ritter30/senior-design/README.md

# G.A.I.N.S Team 19
Cameron Williams \
Max Ritter \
Mark Melvin \
Aidan Leib

## Documentation

All documentation for the project is located in [`./docs`](./docs/).

Hyperlinks to frequently used:

- [Git Commands Cheat Sheet](./docs/git_cheatsheet.md)
- etc...
