ritter30/senior-design/docs/git_cheatsheet.md

## Git Pull
> [!IMPORTANT]
> Make sure to run this command _every_ time to open the project.

```bash
git pull
```

## Checkout/Switch Branches
```bash
git checkout <branch>
```

## Merge Main into Branch
```bash
git checkout <branch>
git fetch origin
git merge origin/main
```
