ritter30/senior-design/app/graphics/accuracy.png

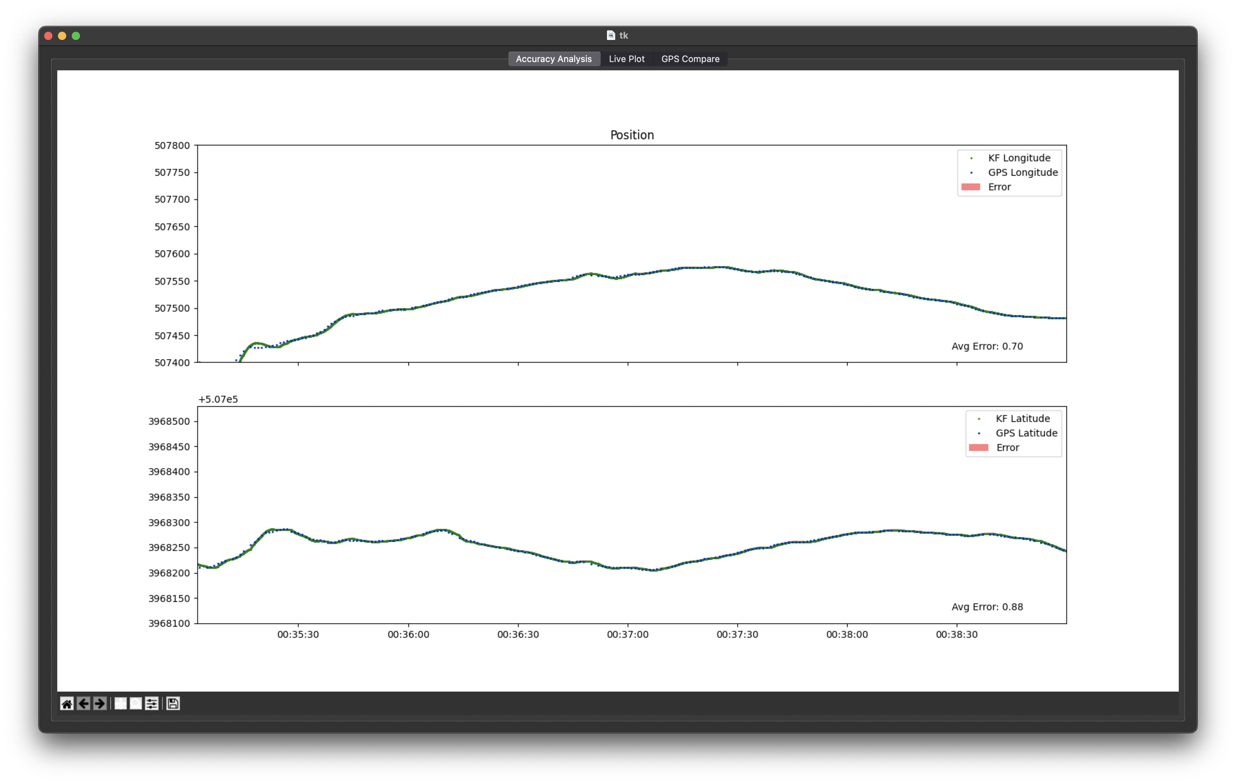
app/graphics/accuracy.png
