ritter30/senior-design/app/graphics/lat_and_lon_with_kf.png

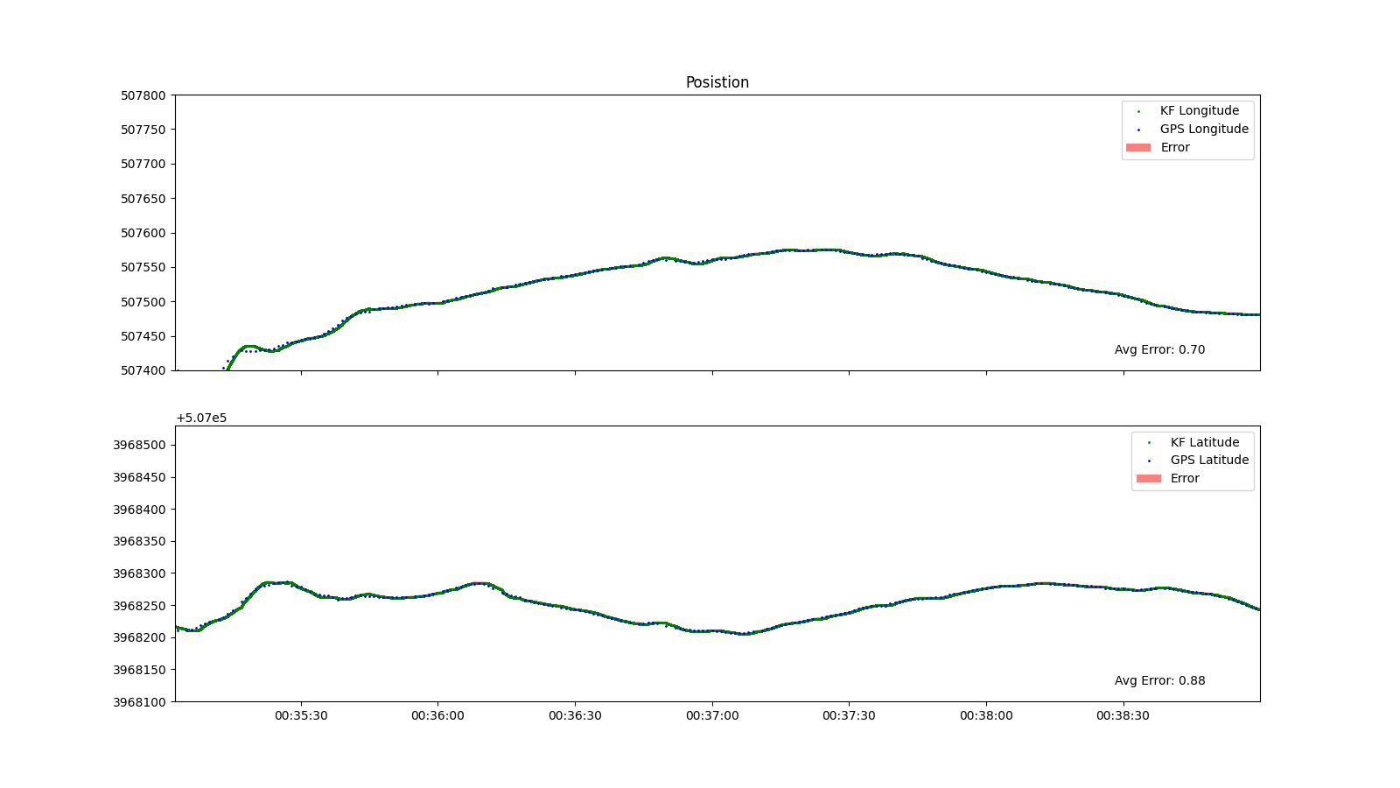
app/graphics/lat_and_lon_with_kf.png
