ritter30/senior-design/app/graphics/my_route_run01.png

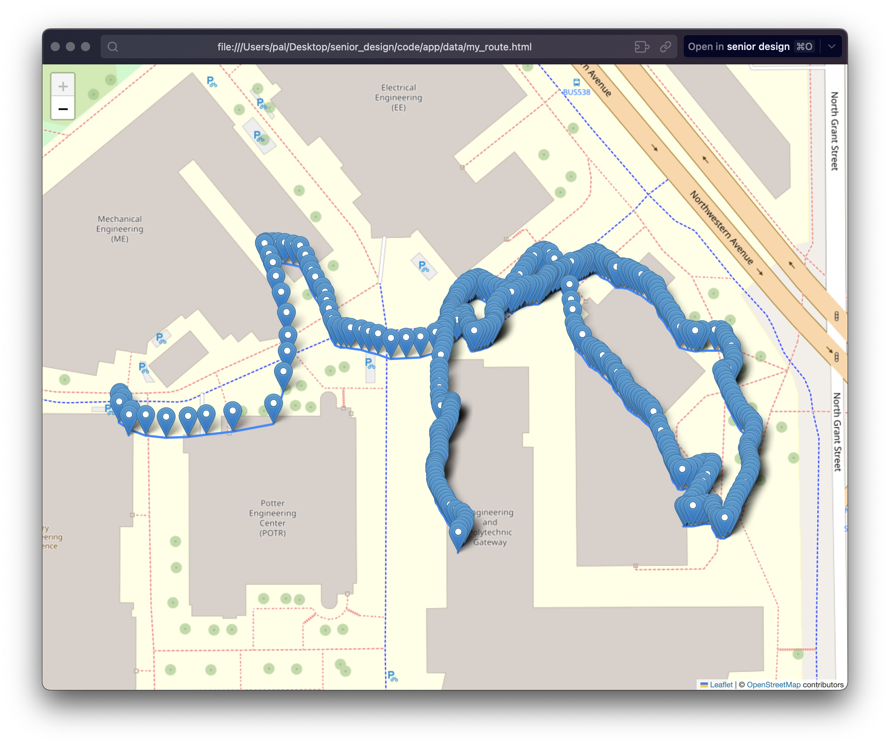
app/graphics/my_route_run01.png
