ritter30/senior-design/app/graphics/orient_demo.png

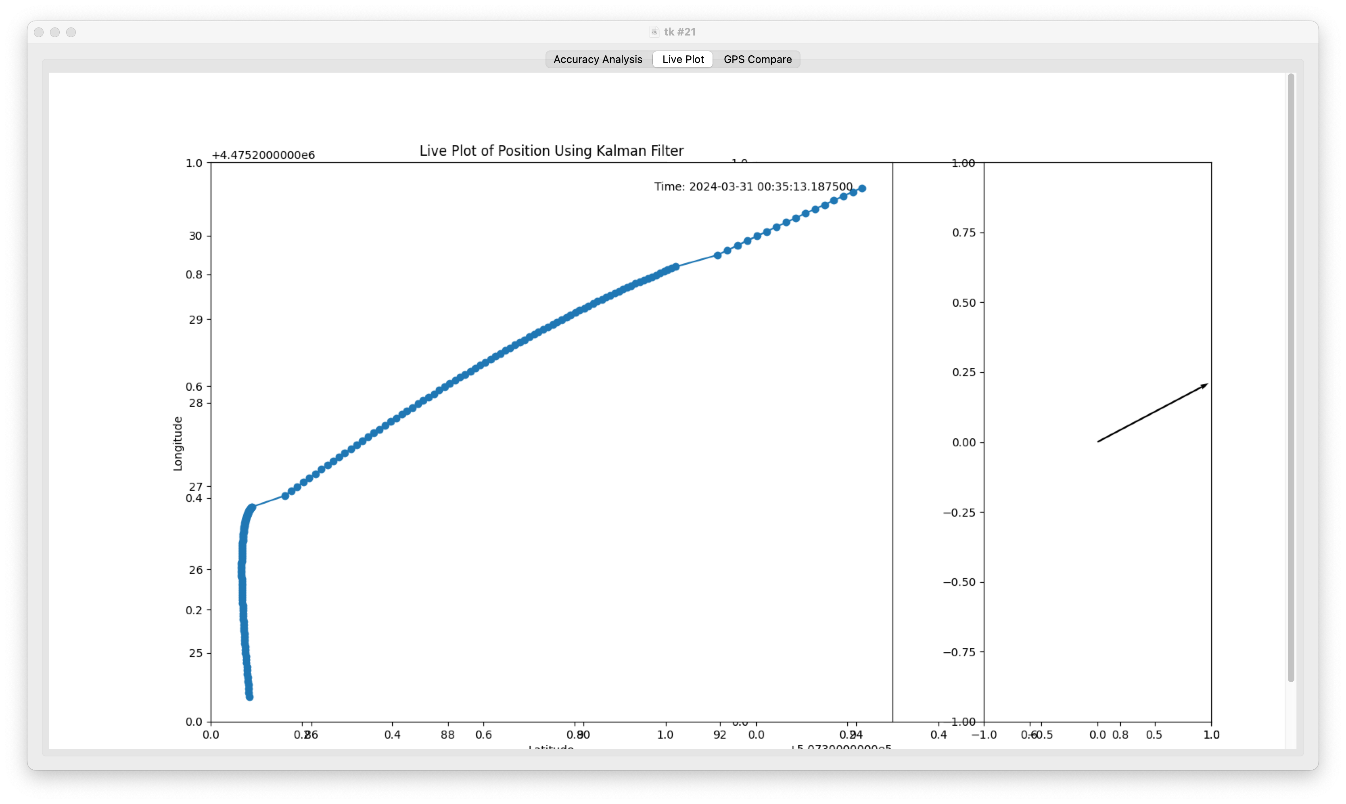
app/graphics/orient_demo.png
