ritter30/senior-design/app/graphics/zoomed_accuracy.png

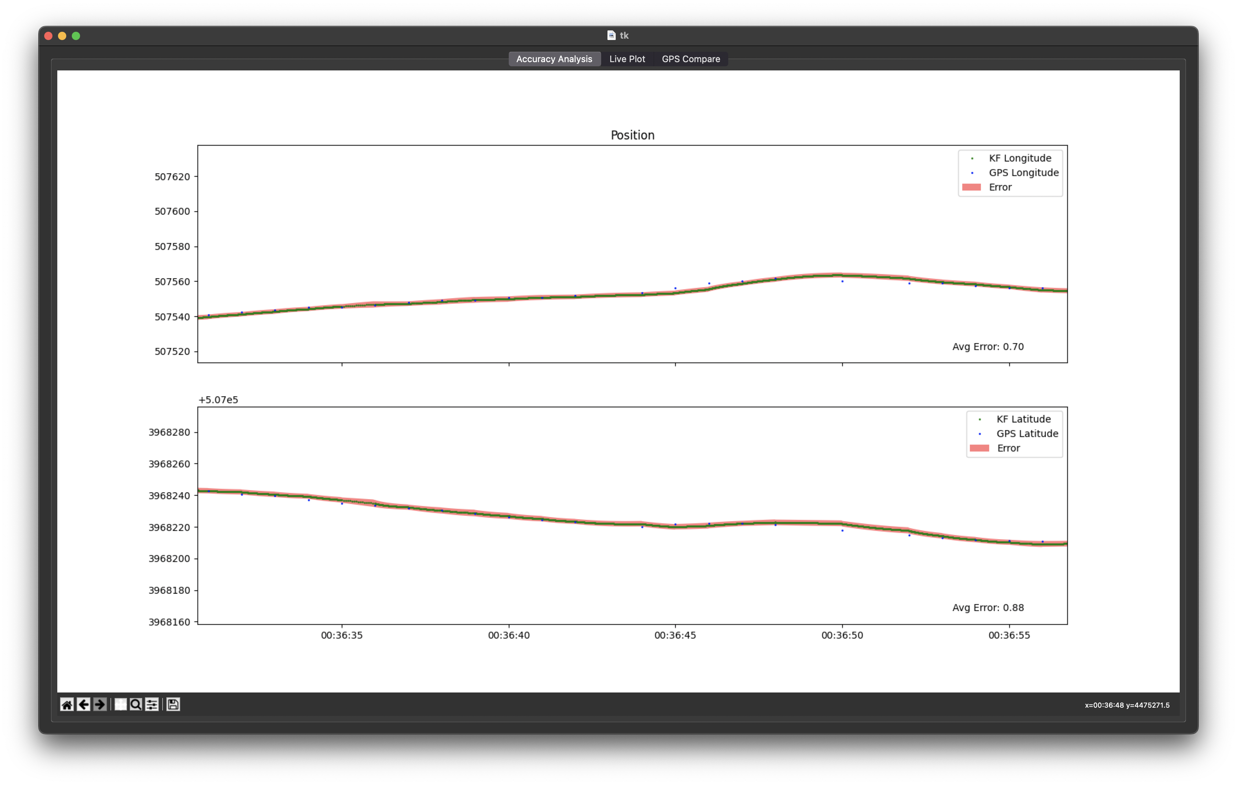
app/graphics/zoomed_accuracy.png
