ritter30/senior-design/Simulations/low_battery_indicator.asc

R1: res; 1k
R2: res; 10k
R3: res; 30k
R4: res; 100k
U1: UniversalOpAmp2
V1: voltage; 5
V2: voltage; SINE(3 1 10)
Named nets: 0, 5V, VIN, VOUT, VHYST
.tran 1
