ritter30/senior-design/Simulations/power_or_diodes.asc

C1: cap; 470µ
D1: diode; A
D2: schottky; 1N5817
R1: res; 10k
V1: voltage; 5V
V2: voltage; PULSE(0 5 0 0.001 0.001 0.05 0.1 100)
Named nets: 0, 5V, VUSB
.model A D(Ron=0.086 Roff=1Meg Vfwd=0.043 Vrev=2)
.tran 1
