ritter30/senior-design/PCBs/GAINS_PCB/GAINS_PCB.kicad_pcb

## KiCad design PCBs/GAINS_PCB/GAINS_PCB.kicad_pcb (2024-04-13)

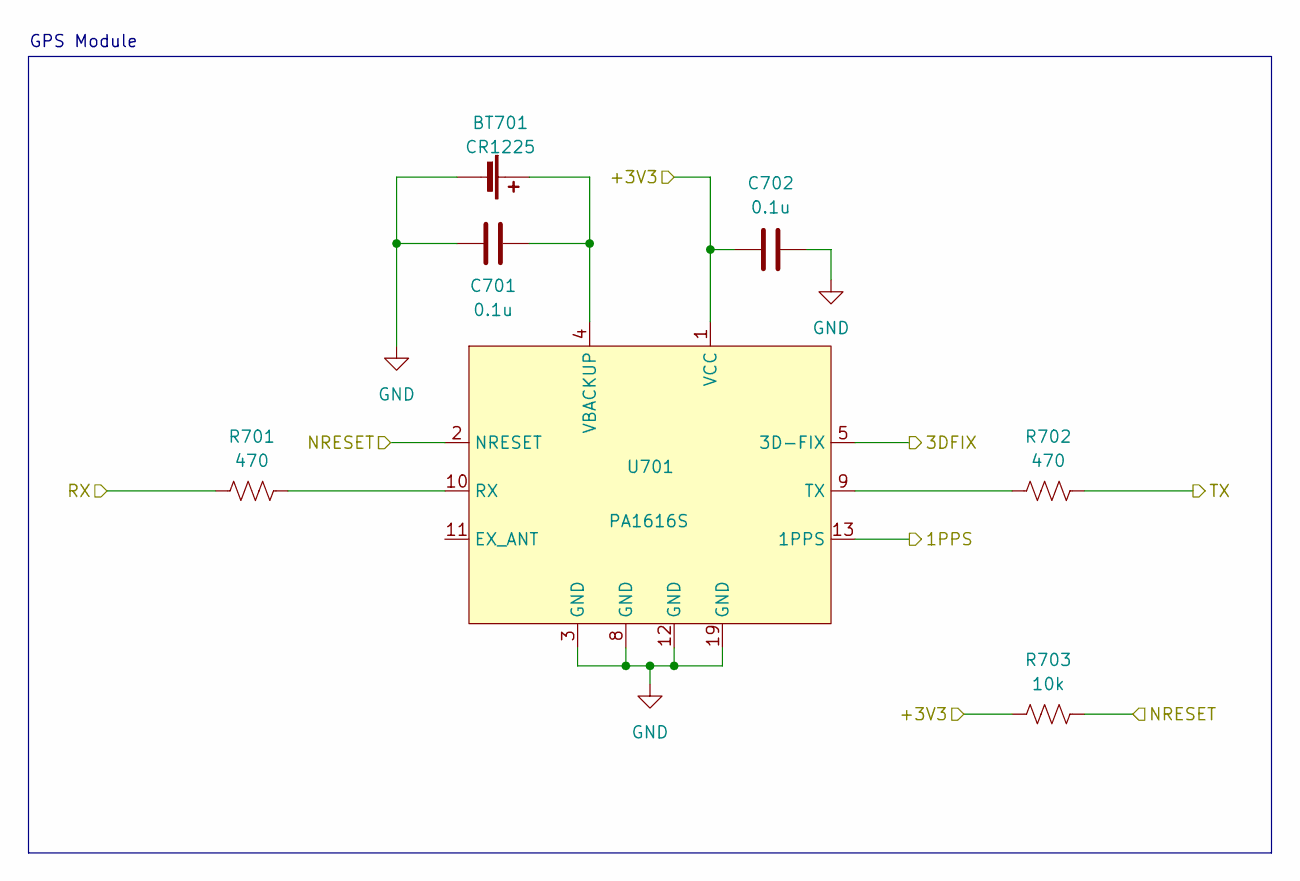
[picture p6: schematic gps.kicad_sch, G.A.I.N.S. GPS Module]

Parts:
BT701: CR1225; Battery_Panasonic_CR1220-VCN_Vertical_CircularHoles
C701, C702: 0.1u; C_0805_2012Metric_Pad1.18x1.45mm_HandSolder
R701, R702: 470; R_0805_2012Metric_Pad1.20x1.40mm_HandSolder
R703: 10k; R_0805_2012Metric_Pad1.20x1.40mm_HandSolder
U701: PA1616S

Connections:
/GPS/1PPS: U701.13 (1PPS); also elsewhere on the board
/GPS/3DFIX: U701.5 (3D-FIX); also elsewhere on the board
/GPS/+3V3: C702.1, R703.1, U701.1 (VCC); also elsewhere on the board
/GPS/NRESET: R703.2, U701.2 (NRESET); also elsewhere on the board
/GPS/RX: R701.1; also elsewhere on the board
/GPS/TX: R702.1; also elsewhere on the board
GND: BT701.2 (-), C701.1, C702.2, U701.3 (GND), U701.8 (GND), U701.12 (GND), U701.19 (GND); also elsewhere on the board
unnamed: BT701.1 (+), C701.2, U701.4 (VBACKUP)
unnamed: R701.2, U701.10 (RX)
unnamed: R702.2, U701.9 (TX)

Notes on the sheet:
GPS Module

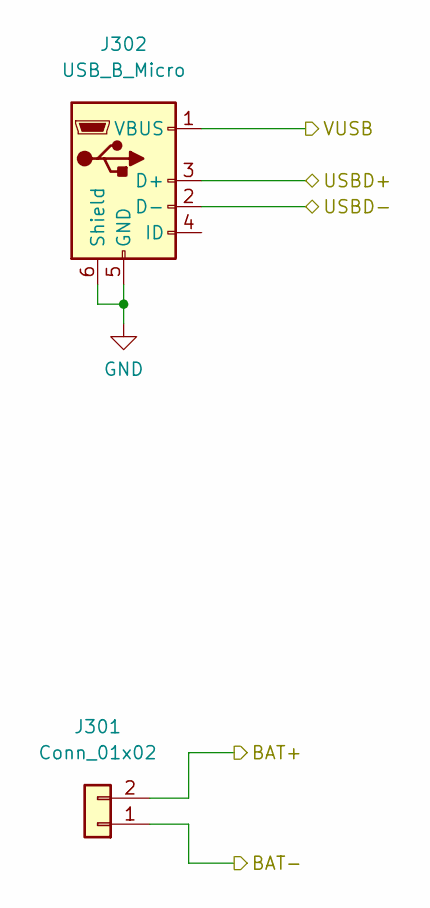
[picture p7: schematic connectors.kicad_sch, G.A.I.N.S. Connectors]

Parts:
J301: Conn_01x02; JST_GH_BM02B-GHS-TBT_1x02-1MP_P1.25mm_Vertical
J302: USB_B_Micro; USB_Micro-B_Amphenol_10104110_Horizontal

Connections:
/Connectors/BAT+: J301.2; also elsewhere on the board
/Connectors/BAT-: J301.1
/Connectors/USBD+: J302.3 (D+); also elsewhere on the board
/Connectors/USBD-: J302.2 (D-); also elsewhere on the board
/Connectors/VUSB: J302.1 (VBUS); also elsewhere on the board
GND: J302.5 (GND), J302.6 (Shield); also elsewhere on the board

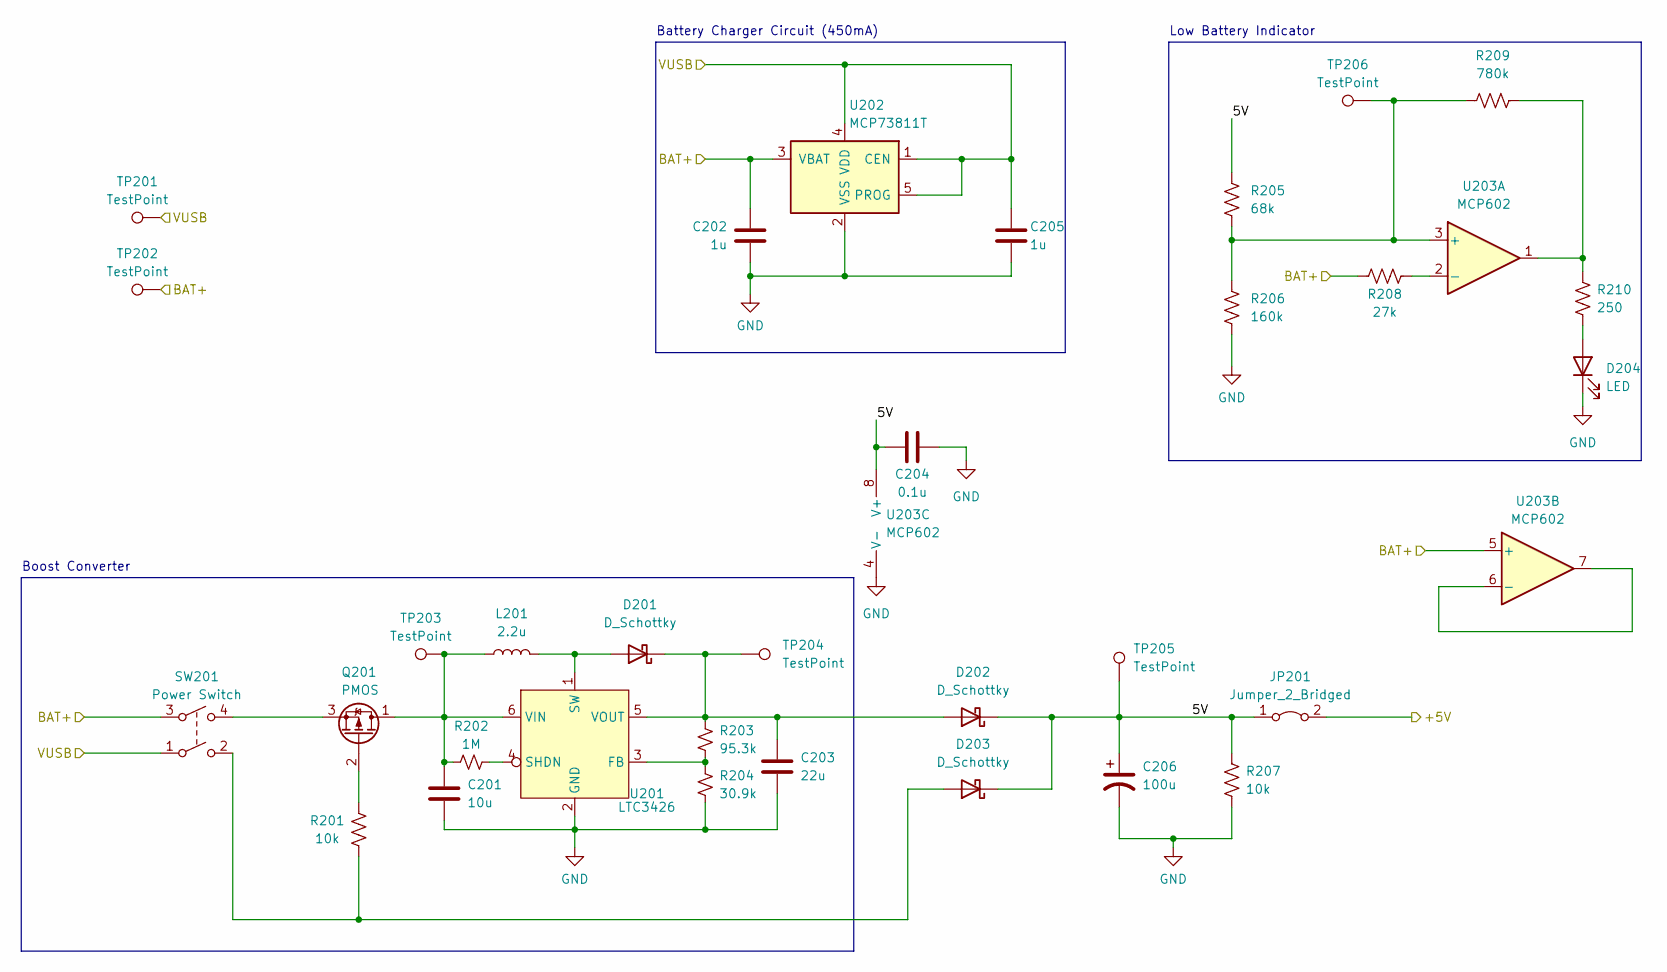
[picture p8: schematic power.kicad_sch, G.A.I.N.S. PSU]

Parts:
C201: 10u; C_0805_2012Metric_Pad1.18x1.45mm_HandSolder
C202, C205: 1u; C_0805_2012Metric_Pad1.18x1.45mm_HandSolder
C203: 22u; CP_Radial_D5.0mm_P2.00mm
C204: 0.1u; C_0805_2012Metric_Pad1.18x1.45mm_HandSolder
C206: 100u; CP_Radial_D10.0mm_P5.00mm
D201, D202, D203: D_Schottky; D_DO-41_SOD81_P10.16mm_Horizontal
D204: LED; LED_D5.0mm
JP201: Jumper_2_Bridged; SolderJumper-2_P1.3mm_Open_Pad1.0x1.5mm
L201: 2.2u; L_Radial_D8.7mm_P5.00mm_Fastron_07HCP
Q201: PMOS; TO-220-3_Vertical
R201, R207: 10k; R_0805_2012Metric_Pad1.20x1.40mm_HandSolder
R202: 1M; R_0805_2012Metric_Pad1.20x1.40mm_HandSolder
R203: 95.3k; R_0805_2012Metric_Pad1.20x1.40mm_HandSolder
R204: 30.9k; R_0805_2012Metric_Pad1.20x1.40mm_HandSolder
R205: 68k; R_0805_2012Metric_Pad1.20x1.40mm_HandSolder
R206: 160k; R_0805_2012Metric_Pad1.20x1.40mm_HandSolder
R208: 27k; R_0805_2012Metric_Pad1.20x1.40mm_HandSolder
R209: 780k; R_0805_2012Metric_Pad1.20x1.40mm_HandSolder
R210: 250; R_0805_2012Metric_Pad1.20x1.40mm_HandSolder
SW201: Power Switch
TP201, TP202, TP203, TP204, TP205, TP206: TestPoint; PinHeader_1x01_P1.27mm_Vertical
U201: LTC3426; TSOT-23-6_HandSoldering
U202: MCP73811T; SOT-23-5_HandSoldering
U203: MCP602; DIP-8_W7.62mm_Socket

Connections:
/Connectors/BAT+: C202.1, R208.1, SW201.3, TP202.1, U202.3 (VBAT), U203.5 (+); also elsewhere on the board
/Connectors/VUSB: C205.1, SW201.1, TP201.1, U202.1 (CEN), U202.4 (VDD), U202.5 (PROG); also elsewhere on the board
/Power/5V: C204.1, C206.1, D202.1 (K), D203.1 (K), JP201.1 (A), R205.2, R207.1, TP205.1, U203.8 (V+)
/Power/+5V: JP201.2 (B); also elsewhere on the board
GND: C201.2, C202.2, C203.2, C204.2, C205.2, C206.2, D204.1 (K), R204.2, R206.1, R207.2, U201.2 (GND), U202.2 (VSS), U203.4 (V-); also elsewhere on the board
unnamed: D201.2 (A), L201.2, U201.1 (SW)
unnamed: C203.1, D201.1 (K), D202.2 (A), R203.1, TP204.1, U201.5 (VOUT)
unnamed: D203.2 (A), R201.1, SW201.2
unnamed: D204.2 (A), R210.2
unnamed: C201.1, L201.1, Q201.1 (D), R202.1, TP203.1, U201.6 (VIN)
unnamed: Q201.2 (G), R201.2
unnamed: Q201.3 (S), SW201.4
unnamed: R209.2, R210.1, U203.1
unnamed: R203.2, R204.1, U201.3 (FB)
unnamed: R202.2, U201.4 (SHDN)
unnamed: R205.1, R206.2, R209.1, TP206.1, U203.3 (+)
unnamed: R208.2, U203.2 (-)
unnamed: U203.6 (-), U203.7

Notes on the sheet:
Boost Converter
Low Battery Indicator
Battery Charger Circuit (450mA)

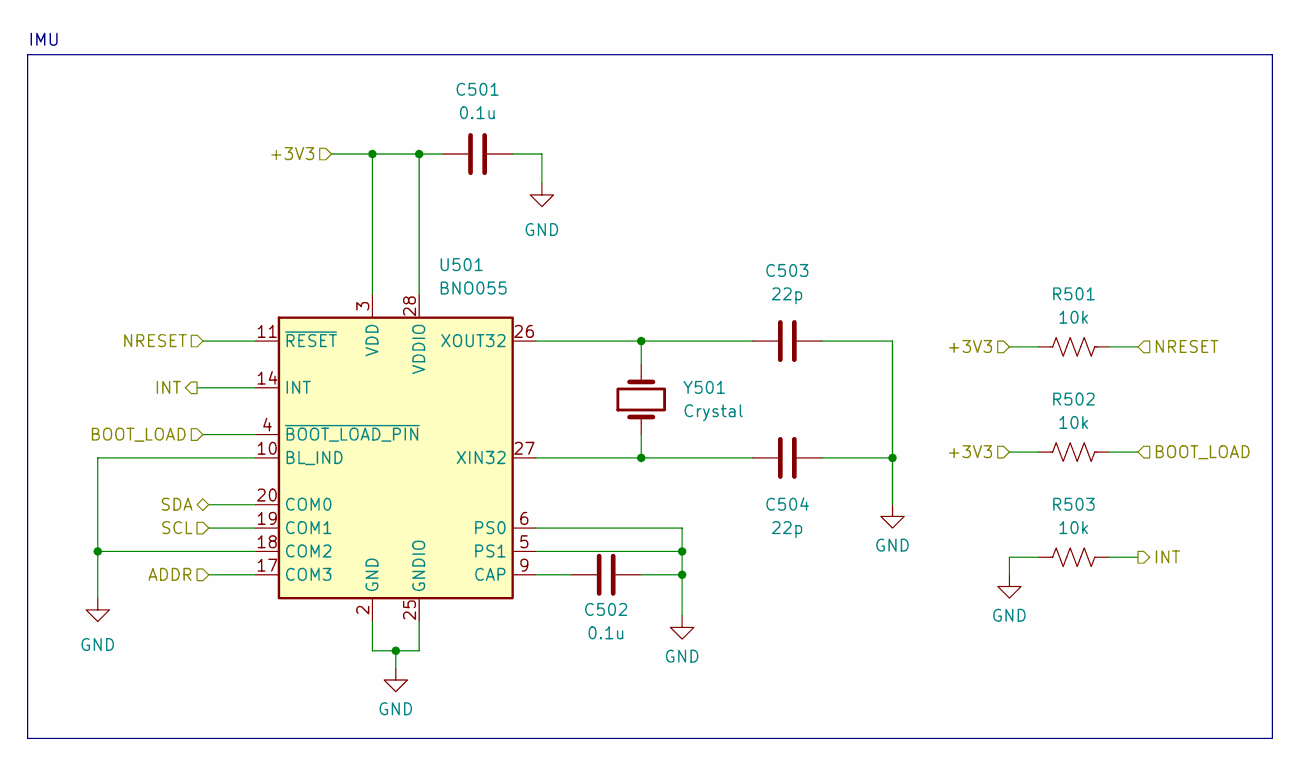
[picture p9: schematic imu0.kicad_sch, G.A.I.N.S. IMU Module]

Parts:
C501, C502: 0.1u
C503, C504: 22p
R501, R502, R503: 10k
U501: BNO055; LGA-28_5.2x3.8mm_P0.5mm
Y501: Crystal

Connections:
/GPS/+3V3: C501.1, R501.1, R502.1, U501.3 (VDD), U501.28 (VDDIO); also elsewhere on the board
/IMU0/BOOT_LOAD: R502.2, U501.4 (~BOOT_LOAD_PIN); also elsewhere on the board
/IMU0/INT: R503.2, U501.14 (INT); also elsewhere on the board
/IMU0/NRESET: R501.2, U501.11 (~RESET); also elsewhere on the board
/IMU0/SCL: U501.19 (COM1); also elsewhere on the board
/IMU0/SDA: U501.20 (COM0); also elsewhere on the board
GND: C501.2, C502.2, C503.1, C504.1, R503.1, U501.2 (GND), U501.5 (PS1), U501.6 (PS0), U501.10 (BL_IND), U501.15 (GNDIO), U501.16 (GNDIO), U501.18 (COM2), U501.25 (GNDIO); also elsewhere on the board
unnamed: C502.1, U501.9 (CAP)
unnamed 45: U501.17 (COM3); also elsewhere on the board
unnamed: C504.2, U501.27 (XIN32), Y501.1
unnamed: C503.2, U501.26 (XOUT32), Y501.2

Notes on the sheet:
IMU

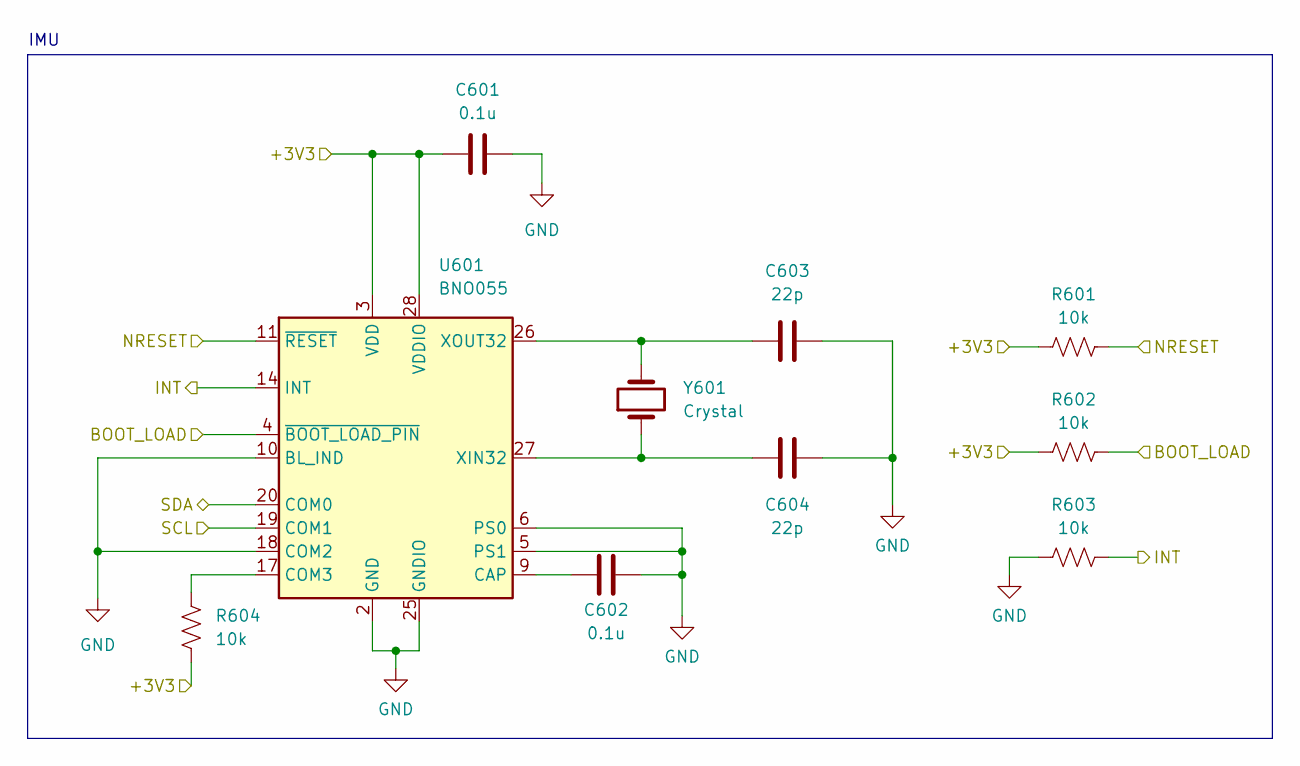
[picture p10: schematic imu1.kicad_sch, G.A.I.N.S. IMU Module]

Parts:
C601, C602: 0.1u; C_0805_2012Metric_Pad1.18x1.45mm_HandSolder
C603, C604: 22p; C_0805_2012Metric_Pad1.18x1.45mm_HandSolder
R601, R602, R603, R604: 10k; R_0805_2012Metric_Pad1.20x1.40mm_HandSolder
U601: BNO055; LGA-28_5.2x3.8mm_P0.5mm
Y601: Crystal; Crystal_DS26_D2.0mm_L6.0mm_Vertical

Connections:
/GPS/+3V3: C601.1, R601.1, R602.1, R604.2, U601.3 (VDD), U601.28 (VDDIO); also elsewhere on the board
/IMU0/SCL: U601.19 (COM1); also elsewhere on the board
/IMU0/SDA: U601.20 (COM0); also elsewhere on the board
/IMU1/BOOT_LOAD: R602.2, U601.4 (~BOOT_LOAD_PIN); also elsewhere on the board
/IMU1/INT: R603.2, U601.14 (INT); also elsewhere on the board
/IMU1/NRESET: R601.2, U601.11 (~RESET); also elsewhere on the board
GND: C601.2, C602.2, C603.1, C604.1, R603.1, U601.2 (GND), U601.5 (PS1), U601.6 (PS0), U601.10 (BL_IND), U601.15 (GNDIO), U601.16 (GNDIO), U601.18 (COM2), U601.25 (GNDIO); also elsewhere on the board
unnamed: C602.1, U601.9 (CAP)
unnamed: R604.1, U601.17 (COM3)
unnamed: C604.2, U601.27 (XIN32), Y601.1
unnamed: C603.2, U601.26 (XOUT32), Y601.2

Notes on the sheet:
IMU

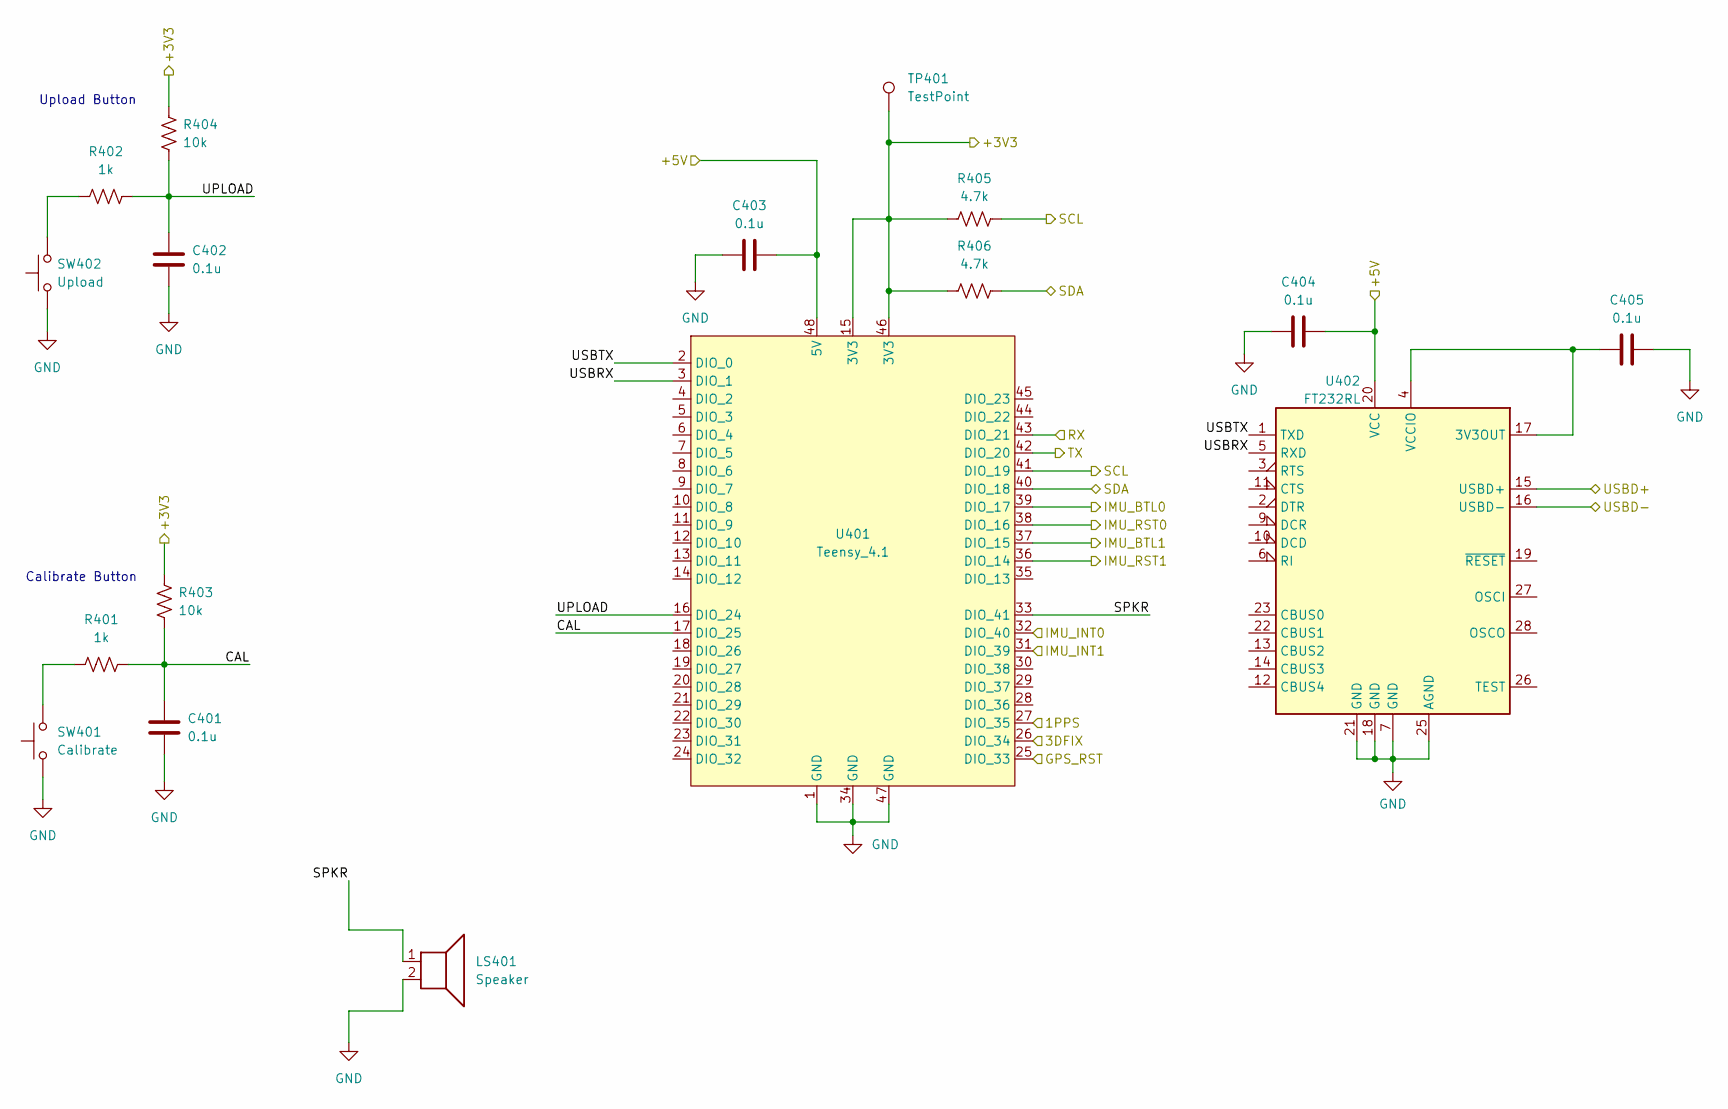
[picture p11: schematic teensy.kicad_sch, G.A.I.N.S. Microcontroller]

Parts:
C401, C402, C403, C404, C405: 0.1u; C_0805_2012Metric_Pad1.18x1.45mm_HandSolder
LS401: Speaker; Buzzer_12x9.5RM7.6
R401, R402: 1k; R_0805_2012Metric_Pad1.20x1.40mm_HandSolder
R403, R404: 10k; R_0805_2012Metric_Pad1.20x1.40mm_HandSolder
R405, R406: 4.7k; R_0805_2012Metric_Pad1.20x1.40mm_HandSolder
SW401: Calibrate; SW_PUSH_6mm
SW402: Upload; SW_PUSH_6mm
TP401: TestPoint; PinHeader_1x01_P1.27mm_Vertical
U401: Teensy_4.1; Teensy41
U402: FT232RL; SSOP-28_5.3x10.2mm_P0.65mm

Connections:
/Connectors/USBD+: U402.15 (USBD+); also elsewhere on the board
/Connectors/USBD-: U402.16 (USBD-); also elsewhere on the board
/GPS/1PPS: U401.27 (DIO_35); also elsewhere on the board
/GPS/3DFIX: U401.26 (DIO_34); also elsewhere on the board
/GPS/+3V3: R403.1, R404.1, R405.1, R406.1, TP401.1, U401.15 (3V3), U401.46 (3V3); also elsewhere on the board
/GPS/NRESET: U401.25 (DIO_33); also elsewhere on the board
/GPS/RX: U401.42 (DIO_20); also elsewhere on the board
/GPS/TX: U401.43 (DIO_21); also elsewhere on the board
/IMU0/BOOT_LOAD: U401.39 (DIO_17); also elsewhere on the board
/IMU0/INT: U401.32 (DIO_40); also elsewhere on the board
/IMU0/NRESET: U401.38 (DIO_16); also elsewhere on the board
/IMU0/SCL: R405.2, U401.41 (DIO_19); also elsewhere on the board
/IMU0/SDA: R406.2, U401.40 (DIO_18); also elsewhere on the board
/IMU1/BOOT_LOAD: U401.37 (DIO_15); also elsewhere on the board
/IMU1/INT: U401.31 (DIO_39); also elsewhere on the board
/IMU1/NRESET: U401.36 (DIO_14); also elsewhere on the board
/Power/+5V: C403.2, C404.1, U401.48 (5V), U402.20 (VCC); also elsewhere on the board
/Teensy/CAL: C401.1, R401.2, R403.2, U401.17 (DIO_25)
/Teensy/SPKR: LS401.1, U401.33 (DIO_41)
/Teensy/UPLOAD: C402.1, R402.2, R404.2, U401.16 (DIO_24)
/Teensy/USBRX: U401.3 (DIO_1), U402.5 (RXD)
/Teensy/USBTX: U401.2 (DIO_0), U402.1 (TXD)
GND: C401.2, C402.2, C403.1, C404.2, C405.1, LS401.2, SW401.1, SW402.1, U401.1 (GND), U401.34 (GND), U401.47 (GND), U402.7 (GND), U402.18 (GND), U402.21 (GND), U402.25 (AGND); also elsewhere on the board
unnamed: R401.1, SW401.2
unnamed: R402.1, SW402.2
unnamed: C405.2, U402.4 (VCCIO), U402.17 (3V3OUT)

Notes on the sheet:
Calibrate Button
Upload Button

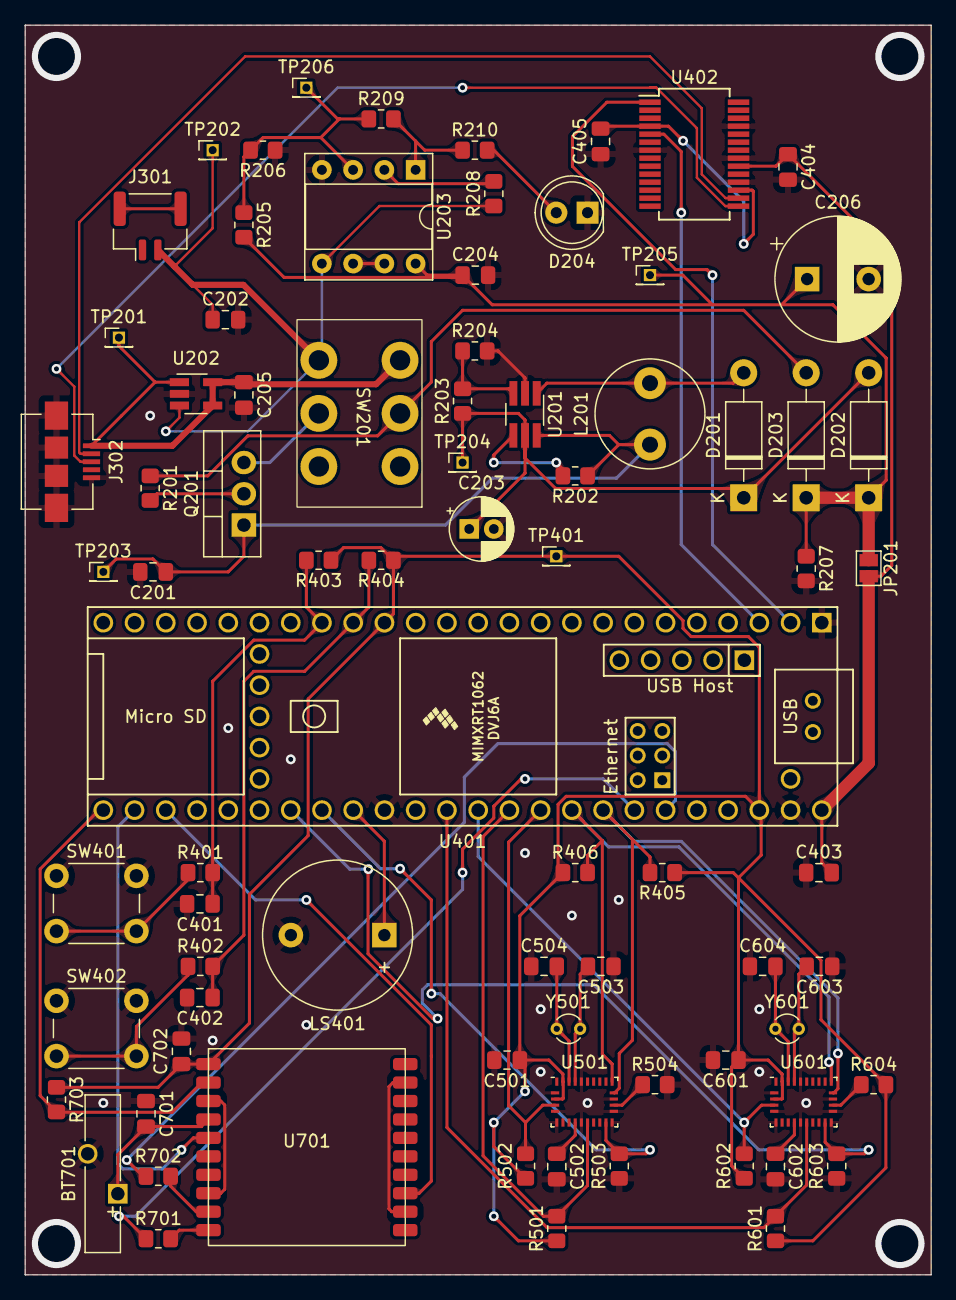
[picture p12: board GAINS_PCB.kicad_pcb from above]

Board: 2 copper layers, 73.7 x 101.6 mm, 79 parts (0 on the bottom side), 53 nets.

Other parts of the board:
R504: 10k; R_0805_2012Metric_Pad1.20x1.40mm_HandSolder

Their connections:
GND: R504.2; also elsewhere on the board
unnamed 45: R504.1; also elsewhere on the board
