ritter30/senior-design/PCBs/breakout_pcb/breakout_pcb.kicad_pcb

## KiCad design PCBs/breakout_pcb/breakout_pcb.kicad_pcb (2024-02-09)

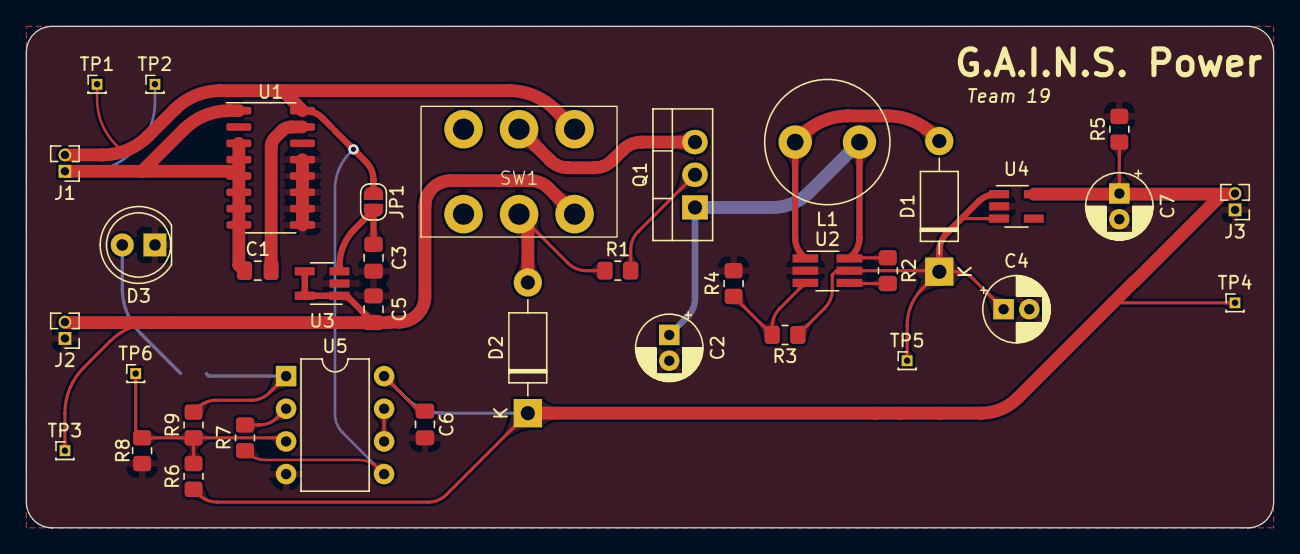
[picture p13: board breakout_pcb.kicad_pcb from above]

Board: 2 copper layers, 97.0 x 39.0 mm, 38 parts (1 on the bottom side), 20 nets.

Parts:
C1, C6: 0.1u; C_0805_2012Metric_Pad1.18x1.45mm_HandSolder
C2: 10u; CP_Radial_D5.0mm_P2.00mm
C3, C5: 1u; C_0805_2012Metric_Pad1.18x1.45mm_HandSolder
C4: 22u; CP_Radial_D5.0mm_P2.00mm
C7: 82u; CP_Radial_D5.0mm_P2.00mm
D1, D2: 1N5819; D_DO-41_SOD81_P10.16mm_Horizontal
D3: Red LED; LED_D5.0mm
J1, J2, J3: Conn_01x02_Socket; PinHeader_1x02_P1.27mm_Vertical
JP1: Jumper_2_Open; SolderJumper-2_P1.3mm_Open_RoundedPad1.0x1.5mm
L1: 2.2u; L_Radial_D9.5mm_P5.00mm_Fastron_07HVP
Q1: IRF9630; TO-220-3_Vertical
R1, R5, R6: 10k; R_0805_2012Metric_Pad1.20x1.40mm_HandSolder
R2: 1M; R_0805_2012Metric_Pad1.20x1.40mm_HandSolder
R3: 95.3k; R_0805_2012Metric_Pad1.20x1.40mm_HandSolder
R4: 30.9k; R_0805_2012Metric_Pad1.20x1.40mm_HandSolder
R7: 1k; R_0805_2012Metric_Pad1.20x1.40mm_HandSolder
R8: 30k; R_0805_2012Metric_Pad1.20x1.40mm_HandSolder
R9: 100k; R_0805_2012Metric_Pad1.20x1.40mm_HandSolder
R10: 250; R_0805_2012Metric_Pad1.20x1.40mm_HandSolder
SW1: SW_DPST; Power Switch
TP1, TP2, TP3, TP4, TP5, TP6: TestPoint; PinHeader_1x01_P1.00mm_Vertical
U1: UCC39562; SOIC-16_3.9x9.9mm_P1.27mm
U2: LTC3426; TSOT-23-6_HandSoldering
U3: MCP73811T; SOT-23-5_HandSoldering
U4: MAX40200AUK; SOT-23-5_HandSoldering
U5: MCP602; DIP-8_W7.62mm

Connections:
/+5V: C6.1, C7.1, D2.1 (K), J3.2, R5.1, R6.1, TP4.1, U4.5 (OUT), U5.8 (V+)
/BAT+: J1.2, JP1.1 (A), R7.1, SW1.3, TP1.1, U1.16 (PACK+), U5.5 (+)
/BAT-: C1.1, J1.1, TP2.1, U1.1 (TCLK), U1.3 (BNEG), U1.4 (BNEG), U1.5 (BNEG), U1.6 (BNEG), U1.7 (BNEG), U1.8 (BNEG)
/VUSB: C5.1, J2.2, SW1.1, TP3.1, U3.1 (CEN), U3.4 (VDD), U3.5 (PROG)
GND: C2.2, C3.2, C4.2, C5.2, C6.2, C7.2, D3.1 (K), J2.1, J3.1, R4.2, R5.2, R8.2, U1.9 (PACK-), U1.10 (PACK-), U1.11 (PACK-), U1.12 (PACK-), U1.13 (PACK-), U2.2 (GND), U3.2 (VSS), U4.2 (GND), U5.4 (V-)
unnamed: D1.2 (A), L1.2, U2.1 (SW)
unnamed: C4.1, D1.1 (K), R3.1, TP5.1, U2.5 (VOUT), U4.1 (VDD), U4.3 (EN)
unnamed: D2.2 (A), R1.1, SW1.2
unnamed: D3.2 (A), R10.2
unnamed: C3.1, JP1.2 (B), U3.3 (VBAT)
unnamed: C2.1, L1.1, Q1.1 (D), R2.1, U2.6 (VIN)
unnamed: Q1.2 (G), R1.2
unnamed: Q1.3 (S), SW1.4
unnamed: R9.2, R10.1, U5.1
unnamed: C1.2, U1.15 (CBPS)
unnamed: R3.2, R4.1, U2.3 (FB)
unnamed: R2.2, U2.4 (SHDN)
unnamed: R6.2, R8.1, R9.1, TP6.1, U5.3 (+)
unnamed: R7.2, U5.2 (-)
unnamed: U5.6 (-), U5.7
