ritter30/senior-design/app/app.py

#%%
from dash import Dash, html, dash_table, dcc, callback, Output, Input
import pandas as pd
import numpy as np
import plotly.express as px
import datetime as dt
import serial
from geo_plot import plot_grand_prix

# import xlwings - for read and write files at the same time

#%%
# Incorporate Data
df = pd.read_csv("./data/noise_accel_data.csv", header=None)
df = df.iloc[:,:3]
df.columns = ['x_accel', 'y_accel', 'z_accel']
df.index

# ser = serial.Serial('/dev/tty.usbserial-0001', 9600)
# ser_df = pd.DataFrame(columns=['x', 'y','z'])
# ser_df.to_csv('./data/serial.csv')

#%%
from gen_sine_wave import gen_sine_wave

gen_sine_wave()

map_df = plot_grand_prix()

#%%
sin_df = pd.read_csv('./data/sine_wave.csv')
#%%
# initalize the app
app = Dash(
    __name__,
    assets_ignore='purdue.*'
    )

app.layout = html.Div(style={'backgroundColor': '#000'}, children=[
    html.Div(
        className='app-header',
        children=[
            html.Div('G.A.I.N.S. Interactive Application MVP',
                     className='app-header--title')
        ],
        style={'textAlign': 'center'}
             ),
    # html.Hr(),
    # html.Div(className='row', children=[
    #     dcc.RadioItems(
    #         options=['x_accel', 'y_accel', 'z_accel'], 
    #         value='x_accel',
    #         id='controls-and-radio-item'
    #         )           
    # ]),
    html.Div(className='row', children=[
        html.H1('Table'),
        html.Div(className='six columns', children=[
            dash_table.DataTable(data=sin_df.to_dict('records'), 
                                    columns=[{'id': c, 'name': c} for c in sin_df.columns],
                                    page_size=10
                                )
        ])
    ]),
    html.H1('Maps'),
    html.Div(className='flex', children=[
        html.Div(className='map', children=[
            html.Iframe(
                id='pu-gp-course',
                srcDoc=open('./data/grand_prix.html', 'r').read(),
                width='100%',
                height='600'
            )
        ], style={'padding': 10, 'flex': 1}),

        html.Br(),

        html.Div(className='map', children=[
            html.Iframe(
                id='my-map',
                srcDoc=open('./data/my_route.html', 'r').read(),
                width='100%',
                height='600'
            )
        ], style={'padding': 10, 'flex': 1})
    ], style={'display': 'flex', 'flexDirection': 'row'}),

    html.Div(className='six columns', children=[
        dcc.Graph(figure={}, id='line-chart-final'),
        dcc.Interval(
            id='live-update',
            interval=1*100,
            n_intervals=0
        )
    ])
])

# add controls to build interaction
# @callback(
#     Output(component_id='line-chart-final', component_property='figure'),
#     Input(component_id='controls-and-radio-item', component_property='value')
# )
# def update_graph(col_chosen):
#     fig = px.line(df, x=df.index, y=col_chosen)
#     return fig

@callback(
    Output('line-chart-final', 'figure'),
    Input('live-update', 'n_intervals')
)
def live_graph(n):
    chunk = 100
    sin_df = pd.read_csv('./data/sine_wave.csv')

    sin_iter = iter(sin_df.itertuples(index=True))

    # data = pd.DataFrame(columns=['t','sin'])

    time = [None] * chunk
    sin = [None] * chunk

    for i in range(chunk):
        try:
            index, t, value = next(sin_iter)

            # print(t, value)
            # time[i] = dt.datetime.now().timestamp()
            time[i] = t + 2*np.pi
            sin[i] = value

            if index == sin_df.shape[0] - 1:
                sin_iter = iter(sin_df.itertuples(index=True))

        except StopIteration:
            sin_iter = iter(sin_df.itertuples(index=True))

    data = pd.DataFrame({
        't': time,
        'sin': sin
    })

    sin_df.iloc[:-chunk,:] = sin_df.iloc[chunk:, :] # slide data to the left
    sin_df.iloc[-chunk:,:] = data # postfix new data to front

    sin_df.to_csv('./data/sine_wave.csv', index=False)

    ############# Serial

    # try:
    #     line = ser.readline().decode().strip()

    # except KeyboardInterrupt:
    #     ser.close()

    # row = np.array(line.split(',')[:-1])

    # data = np.genfromtxt('./data/serial.csv', delimiter=',', usemask=True)
    # data = np.append([data, row], axis=0)

    # data_df = pd.DataFrame(data)
    # data_df.to_csv('./data/serial.csv', index=False)

    fig = {
        'data': [
            {'x': sin_df['t'], 'y': sin_df['sin'], 'type': 'line', 'name': 'Live Data'}
        ],
        'layout': {
            'margin': {'l': 30, 'r': 20, 'b': 20, 't': 20},
            'xaxis': {'title': 'Time'},
            'yaxis': {'title': 'Sine'}
        }
    }

    return fig

if __name__ == '__main__':
    app.run(debug=True)

# %%
