ritter30/senior-design/(commit log)

2024-01-25 Added PCB
    [GAINS_PCB.kicad_pcb, GAINS_PCB.kicad_sch]
2024-01-26 Initial PCB Schematic
    [GAINS_PCB.kicad_sch, connectors.kicad_sch, gps.kicad_sch, imu0.kicad_sch, power.kicad_sch, teensy.kicad_sch]
2024-01-26 Teensy and IMU PCB Schematics
    [GAINS_PCB.kicad_sch, gps.kicad_sch, imu0.kicad_sch, teensy.kicad_sch]
2024-01-28 PCB Schematic Updates
    [GAINS_PCB.kicad_sch, connectors.kicad_sch, gps.kicad_sch, imu0.kicad_sch, power.kicad_sch, teensy.kicad_sch]
2024-01-30 minor changes
    [GAINS_PCB.kicad_sch, connectors.kicad_sch, gps.kicad_sch, imu0.kicad_sch, power.kicad_sch, teensy.kicad_sch]
2024-01-30 Fixing Schematic
    [GAINS_PCB.kicad_sch, connectors.kicad_sch, gps.kicad_sch, imu0.kicad_sch, power.kicad_sch, teensy.kicad_sch]
2024-02-01 PCB Updates
    [GAINS_PCB.kicad_sch, connectors.kicad_sch, gps.kicad_sch, imu0.kicad_sch, power.kicad_sch, teensy.kicad_sch]
2024-02-02 removing schematic from branch 'aidan'
    [GAINS_PCB.kicad_pcb, GAINS_PCB.kicad_sch, connectors.kicad_sch, gps.kicad_sch, imu0.kicad_sch, power.kicad_sch, teensy.kicad_sch]
2024-02-02 introduction to building the application, added styling files and data
    [noise_accel_data.csv]
2024-02-05 Attempting live data updates
    [sine_wave.csv]
2024-02-05 Working live update mvp App
    [sine_wave.csv]
2024-02-08 Updated battery protection circuit
    [power.kicad_sch, teensy.kicad_sch]
2024-02-08 Added the breakout board PCB
    [GAINS_PCB.kicad_sch, breakout_pcb.kicad_pcb, breakout_pcb.kicad_sch, connectors.kicad_sch, gps.kicad_sch, imu0.kicad_sch, power.kicad_sch, teensy.kicad_sch]
2024-02-08 init for pyserial implementation
    [serial.csv, sine_wave.csv]
2024-02-09 Worked on PCB
    [breakout_pcb.kicad_pcb]
2024-02-09 updated power breakout board
    [breakout_pcb.kicad_pcb, breakout_pcb.kicad_sch]
2024-02-09 Final Breakout Board PCB
    [breakout_pcb.kicad_pcb, breakout_pcb.kicad_sch]
2024-02-12 build gerber files for ordering PCB
    [breakout_pcb-B_Cu.gbl, breakout_pcb-B_Mask.gbs, breakout_pcb-B_Paste.gbp, breakout_pcb-B_Silkscreen.gbo, breakout_pcb-Edge_Cuts.gm1, breakout_pcb-F_Cu.gtl, breakout_pcb-F_Mask.gts, breakout_pcb-F_Paste.gtp]
2024-02-13 playing with plotting geospatial data
    [purdue_grand_prix.csv]
2024-02-14 negiligible updates to app
    [sine_wave.csv]
2024-02-15 pushing working tree, only changed app print()
2024-02-15 added kalman filter script to play with
    [sine_wave.csv]
2024-02-17 Deleted battery protectection circuit and ideal diode
    [power.kicad_sch]
2024-02-17 Changed resistor values for low battery indicator
    [power.kicad_sch]
2024-02-19 fleshed out 1D kalman filter example --> next apply to 3D
2024-02-20 midterm demo app working checkpoint
    [gps_data.csv, sine_wave.csv]
2024-02-20 additional mods to app for midterm demo
    [sine_wave.csv]
2024-02-20 editted serial in
    [sine_wave.csv]
2024-02-20 post midterm demo
    [sine_wave.csv]
2024-03-04 GAINS PCB Rev 1
    [GAINS_PCB.kicad_pcb, connectors.kicad_sch, gps.kicad_sch, imu0.kicad_sch, power.kicad_sch, teensy.kicad_sch]
2024-03-05 attempting multivariate kalman filter in python
2024-03-21 i think i figured out the matrices for our kalman filter implementation. Still need to look into some shape differences and the initial P matrix (state cov).
    [noise_accel_data.csv]
2024-03-26 kalman filter designed, want to test with IMU and GPS data now (sensor fusion)
    [downstairs_accel_data.csv]
2024-04-02 data cleaning from max's collection to test kalman filter. need to input imu and gps into kf next.
    [imu_and_gps_01.csv, run01_gps.csv]
2024-04-02 temp commit to switch branch
    [gps_formatted.csv]
2024-04-05 Working fused kalman filter. Need to figure out good ways to visualize results.
    [run01_gps.csv]
2024-04-09 added tkinter app in case it's easier to plot live
2024-04-13 Adding new data
    [fused_run01.csv, imu_gps_gyro02.csv]
2024-04-13 Added arduino folder structure
2024-04-13 updated .gitignore file
    [run01_imu.csv]
2024-04-17 addedd c++ kalman filter
2024-04-17 moving kalman filter to micro code location
2024-04-18 more edits to c++ kalman filter, moving on to focusing hte UI
2024-04-23 good enough UI i think
    [fused_run01.csv, fused_run02.csv]
